markusb/esp-dmx/dmx512.png

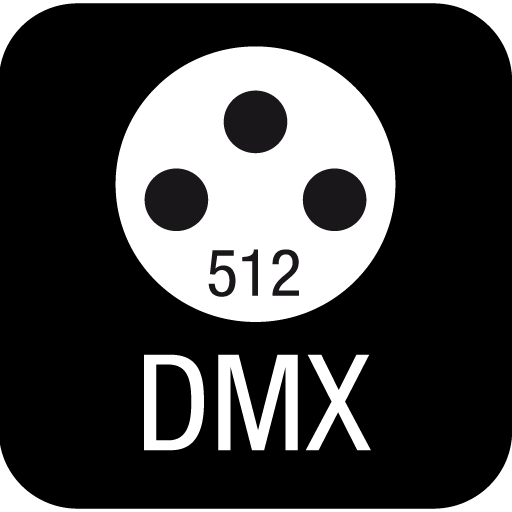
dmx512.png
