markusb/esp-dmx/Schematics.png

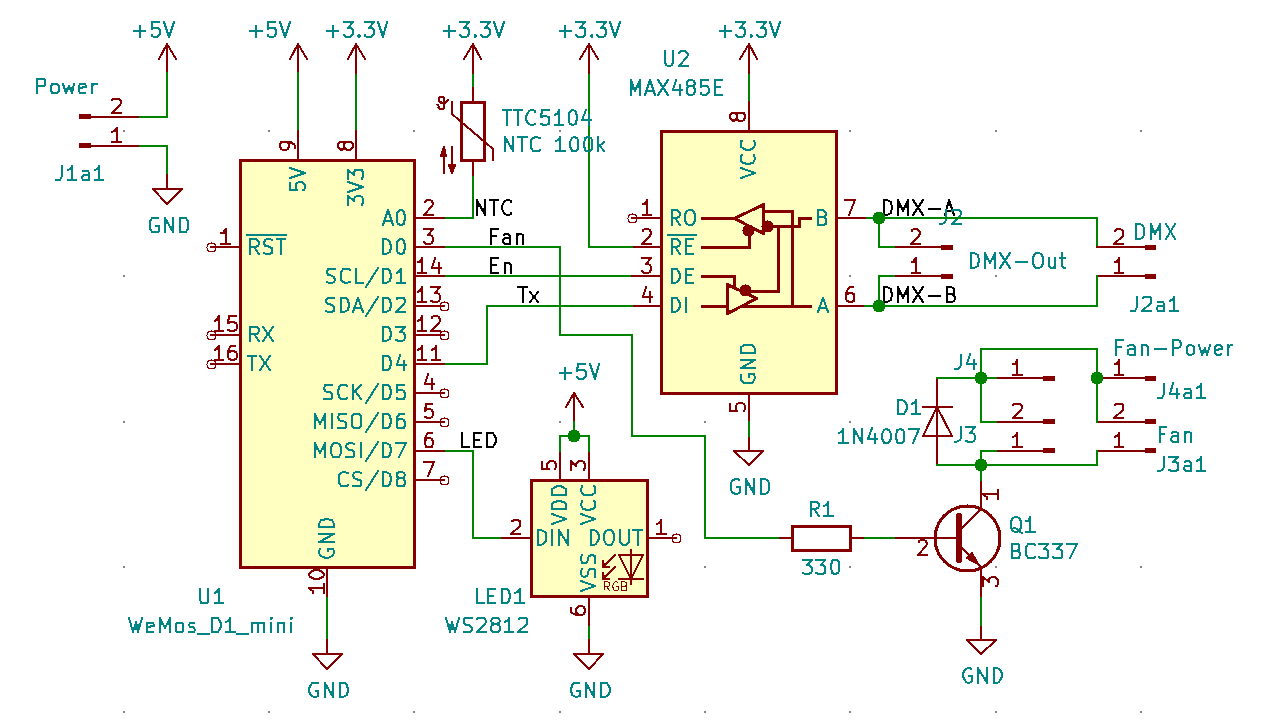
Schematics.png
