markusb/esp-dmx/Wiring-Diagram.png

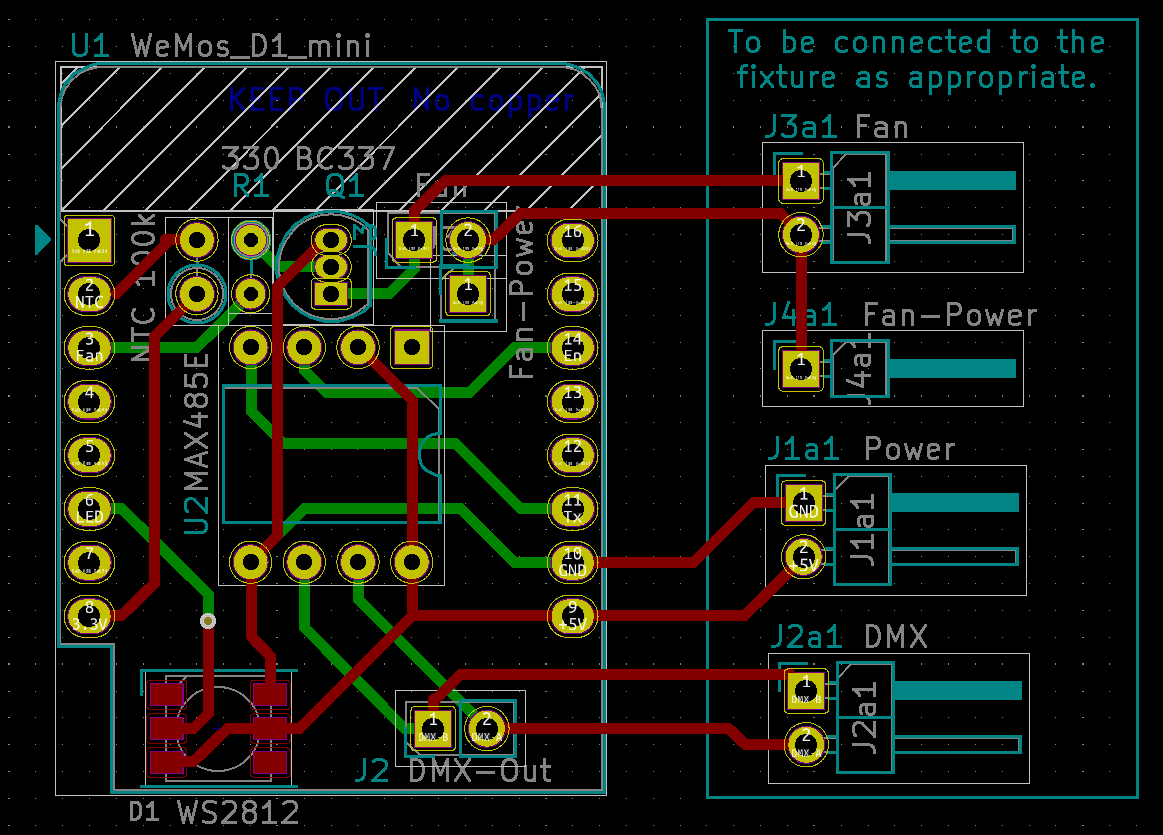
Wiring-Diagram.png
