markusb/esp-dmx/dmx512.h

/*
 * binary data for the ESP-DMX png logo
 */
 
#ifndef _DMX512_PNG_H_
#define _DMX512_PNG_H_

const char PROGMEM dmx512_png_ctype[] = "image/png";

unsigned int dmx512_png_len = 13726;

const char PROGMEM dmx512_png[] = {
  0x89, 0x50, 0x4e, 0x47, 0x0d, 0x0a, 0x1a, 0x0a, 0x00, 0x00, 0x00, 0x0d,
  0x49, 0x48, 0x44, 0x52, 0x00, 0x00, 0x02, 0x00, 0x00, 0x00, 0x02, 0x00,
  0x08, 0x06, 0x00, 0x00, 0x00, 0xf4, 0x78, 0xd4, 0xfa, 0x00, 0x00, 0x00,
  0x19, 0x74, 0x45, 0x58, 0x74, 0x53, 0x6f, 0x66, 0x74, 0x77, 0x61, 0x72,
  0x65, 0x00, 0x41, 0x64, 0x6f, 0x62, 0x65, 0x20, 0x49, 0x6d, 0x61, 0x67,
  0x65, 0x52, 0x65, 0x61, 0x64, 0x79, 0x71, 0xc9, 0x65, 0x3c, 0x00, 0x00,
  0x35, 0x40, 0x49, 0x44, 0x41, 0x54, 0x78, 0xda, 0xec, 0xdd, 0x4f, 0x4c,
  0x5c, 0x67, 0xba, 0xe7, 0xf1, 0x83, 0x9d, 0xc5, 0xac, 0x30, 0xd9, 0x8d,
  0x34, 0x46, 0xc1, 0xab, 0xd1, 0x84, 0x48, 0x86, 0xb9, 0x8a, 0xae, 0xed,
  0x8d, 0x41, 0x73, 0xd5, 0x60, 0x8d, 0x66, 0x0c, 0x51, 0xc7, 0x59, 0x1a,
  0x62, 0x1c, 0xe5, 0xae, 0x00, 0x27, 0xdb, 0x34, 0x45, 0xb2, 0xb9, 0x57,
  0x4a, 0x8c, 0x59, 0x45, 0x4a, 0xec, 0x06, 0xcf, 0x5d, 0xc5, 0x6e, 0x35,
  0xb0, 0x0a, 0x44, 0xdd, 0x32, 0x6c, 0x92, 0x5c, 0x45, 0x73, 0xc1, 0x92,
  0xf1, 0x48, 0xb3, 0x01, 0x0b, 0x5a, 0x6a, 0xcd, 0x5d, 0x18, 0xb3, 0xea,
  0x5e, 0x31, 0xf5, 0x2b, 0xd7, 0x71, 0x03, 0xae, 0x2a, 0xea, 0x3d, 0x75,
  0xfe, 0xbc, 0x7f, 0xbe, 0x1f, 0xa9, 0x42, 0xe2, 0x18, 0xa8, 0x3a, 0x75,
  0xea, 0x3c, 0xcf, 0xfb, 0xbc, 0xcf, 0xfb, 0x9e, 0xb6, 0x83, 0x83, 0x83,
  0x08, 0x00, 0x00, 0x84, 0xe5, 0x14, 0x87, 0x00, 0x00, 0x00, 0x12, 0x00,
  0x00, 0x00, 0x10, 0x80, 0x36, 0x0e, 0xc1, 0x6b, 0x7a, 0xca, 0x8f, 0x8e,
  0xea, 0xa3, 0xe7, 0xd8, 0xff, 0xbb, 0xcc, 0xe1, 0x01, 0x00, 0x6b, 0xad,
  0x1d, 0xfb, 0xef, 0x8d, 0xf2, 0x63, 0xaf, 0xfa, 0xd8, 0xe0, 0xf0, 0x90,
  0x00, 0xc4, 0xfa, 0xaa, 0x01, 0xfe, 0xad, 0xea, 0xd7, 0x38, 0xf0, 0x03,
  0x00, 0xfc, 0x14, 0x27, 0x02, 0x7a, 0x3c, 0xab, 0x7e, 0x5d, 0x25, 0x01,
  0xf0, 0x5b, 0x57, 0x35, 0xe0, 0x5f, 0x3e, 0x14, 0xec, 0x01, 0x00, 0x88,
  0x0e, 0x25, 0x05, 0x6b, 0xd5, 0x84, 0x60, 0x9b, 0x04, 0xc0, 0x6d, 0x43,
  0xd5, 0x80, 0x3f, 0x54, 0x4d, 0x00, 0x00, 0x00, 0x68, 0x86, 0x12, 0x80,
  0xc5, 0x6a, 0x42, 0xb0, 0x48, 0x02, 0xe0, 0x4e, 0xd0, 0xbf, 0x5a, 0xfd,
  0x4a, 0x39, 0x1f, 0x00, 0xd0, 0xaa, 0xbd, 0x6a, 0x12, 0xb0, 0xe4, 0x5b,
  0x32, 0xe0, 0x43, 0x02, 0xa0, 0x72, 0xfe, 0x38, 0x41, 0x1f, 0x00, 0x90,
  0x53, 0x32, 0x30, 0x1b, 0x79, 0xd0, 0x54, 0xe8, 0x72, 0x02, 0x30, 0x52,
  0x0d, 0xfc, 0xcc, 0xe7, 0x03, 0x00, 0xf2, 0xb6, 0x51, 0x4d, 0x04, 0xe6,
  0x49, 0x00, 0xf2, 0xa1, 0x11, 0xfe, 0x44, 0x35, 0xf0, 0x33, 0xda, 0x07,
  0x00, 0xd8, 0x50, 0x15, 0x50, 0x22, 0x70, 0xa7, 0xfa, 0xef, 0x24, 0x00,
  0x04, 0x7e, 0x00, 0x00, 0x89, 0x00, 0x09, 0x00, 0x81, 0x1f, 0x00, 0x40,
  0x22, 0x40, 0x02, 0xd0, 0x94, 0x12, 0x81, 0x1f, 0x00, 0xe0, 0x78, 0x22,
  0x50, 0x22, 0x01, 0x68, 0x5e, 0x5f, 0xf9, 0x31, 0x17, 0xb1, 0x76, 0x1f,
  0x00, 0xe0, 0xbe, 0xed, 0xf2, 0x63, 0x34, 0xb2, 0x70, 0xc7, 0x41, 0x9b,
  0x12, 0x80, 0x8e, 0x6a, 0xe0, 0x1f, 0xe2, 0x7c, 0x01, 0x00, 0x78, 0x66,
  0xb1, 0x9a, 0x08, 0x58, 0x33, 0x2d, 0x60, 0x4b, 0x02, 0x30, 0x54, 0x0d,
  0xfe, 0x94, 0xfb, 0x01, 0x00, 0xbe, 0xda, 0xab, 0x26, 0x01, 0x56, 0x6c,
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
};

#endif
