markusb/esp-dmx/favicon.h

/*
 * favicon binary data for the ESP-DMX webinterface
 */

#ifndef _FAVICON_H_
#define _FAVICON_H_

const char PROGMEM favicon_ctype[] = "application/octet-stream";

const unsigned int favicon_ico_len = 15406;

const char PROGMEM favicon_ico[] = {
  0x00, 0x00, 0x01, 0x00, 0x03, 0x00, 0x10, 0x10, 0x00, 0x00, 0x01, 0x00,
  0x20, 0x00, 0x68, 0x04, 0x00, 0x00, 0x36, 0x00, 0x00, 0x00, 0x20, 0x20,
  0x00, 0x00, 0x01, 0x00, 0x20, 0x00, 0x28, 0x11, 0x00, 0x00, 0x9e, 0x04,
  0x00, 0x00, 0x30, 0x30, 0x00, 0x00, 0x01, 0x00, 0x20, 0x00, 0x68, 0x26,
  0x00, 0x00, 0xc6, 0x15, 0x00, 0x00, 0x28, 0x00, 0x00, 0x00, 0x10, 0x00,
  0x00, 0x00, 0x20, 0x00, 0x00, 0x00, 0x01, 0x00, 0x20, 0x00, 0x00, 0x00,
  0x00, 0x00, 0x00, 0x00, 0x00, 0x00, 0x00, 0x00, 0x00, 0x00, 0x00, 0x00,
  0x00, 0x00, 0x00, 0x00, 0x00, 0x00, 0x00, 0x00, 0x00, 0x00, 0x00, 0x00,
  0x00, 0x1e, 0x00, 0x00, 0x00, 0xb2, 0x00, 0x00, 0x00, 0xe3, 0x00, 0x00,
  0x00, 0xe5, 0x00, 0x00, 0x00, 0xe5, 0x00, 0x00, 0x00, 0xe5, 0x00, 0x00,
  0x00, 0xe5, 0x00, 0x00, 0x00, 0xe5, 0x00, 0x00, 0x00, 0xe5, 0x00, 0x00,
  0x00, 0xe5, 0x00, 0x00, 0x00, 0xe5, 0x00, 0x00, 0x00, 0xe5, 0x00, 0x00,
  0x00, 0xe5, 0x00, 0x00, 0x00, 0xe3, 0x00, 0x00, 0x00, 0xae, 0x00, 0x00,
  0x00, 0x1b, 0x00, 0x00, 0x00, 0xc7, 0x00, 0x00, 0x00, 0xff, 0x00, 0x00,
  0x00, 0xff, 0x00, 0x00, 0x00, 0xff, 0x09, 0x09, 0x09, 0xff, 0x0b, 0x0b,
  0x0b, 0xff, 0x03, 0x03, 0x03, 0xff, 0x06, 0x06, 0x06, 0xff, 0x06, 0x06,
  0x06, 0xff, 0x0d, 0x0d, 0x0d, 0xff, 0x00, 0x00, 0x00, 0xff, 0x07, 0x07,
  0x07, 0xff, 0x00, 0x00, 0x00, 0xff, 0x00, 0x00, 0x00, 0xff, 0x00, 0x00,
  0x00, 0xff, 0x00, 0x00, 0x00, 0xbf, 0x00, 0x00, 0x00, 0xff, 0x00, 0x00,
  0x00, 0xff, 0x00, 0x00, 0x00, 0xff, 0x00, 0x00, 0x00, 0xff, 0x69, 0x69,
  0x69, 0xff, 0x5e, 0x5e, 0x5e, 0xff, 0x5f, 0x5f, 0x5f, 0xff, 0x77, 0x77,
  0x77, 0xff, 0x6e, 0x6e, 0x6e, 0xff, 0x76, 0x76, 0x76, 0xff, 0x5f, 0x5f,
  0x5f, 0xff, 0x45, 0x45, 0x45, 0xff, 0x00, 0x00, 0x00, 0xff, 0x00, 0x00,
  0x00, 0xff, 0x00, 0x00, 0x00, 0xff, 0x00, 0x00, 0x00, 0xfd, 0x00, 0x00,
  0x00, 0xff, 0x00, 0x00, 0x00, 0xff, 0x00, 0x00, 0x00, 0xff, 0x00, 0x00,
  0x00, 0xff, 0x61, 0x61, 0x61, 0xff, 0x08, 0x08, 0x08, 0xff, 0x8b, 0x8b,
  0x8b, 0xff, 0x8d, 0x8d, 0x8d, 0xff, 0x6d, 0x6d, 0x6d, 0xff, 0x4d, 0x4d,
  0x4d, 0xff, 0xa7, 0xa7, 0xa7, 0xff, 0x01, 0x01, 0x01, 0xff, 0x00, 0x00,
  0x00, 0xff, 0x00, 0x00, 0x00, 0xff, 0x00, 0x00, 0x00, 0xff, 0x00, 0x00,
  0x00, 0xff, 0x00, 0x00, 0x00, 0xff, 0x00, 0x00, 0x00, 0xff, 0x00, 0x00,
  0x00, 0xff, 0x00, 0x00, 0x00, 0xff, 0x62, 0x62, 0x62, 0xff, 0x64, 0x64,
  0x64, 0xff, 0x53, 0x53, 0x53, 0xff, 0x7c, 0x7c, 0x7c, 0xff, 0x5f, 0x5f,
  0x5f, 0xff, 0x6c, 0x6c, 0x6c, 0xff, 0x56, 0x56, 0x56, 0xff, 0x41, 0x41,
  0x41, 0xff, 0x00, 0x00, 0x00, 0xff, 0x00, 0x00, 0x00, 0xff, 0x00, 0x00,
  0x00, 0xff, 0x00, 0x00, 0x00, 0xff, 0x00, 0x00, 0x00, 0xff, 0x00, 0x00,
  0x00, 0xff, 0x00, 0x00, 0x00, 0xff, 0x00, 0x00, 0x00, 0xff, 0x00, 0x00,
  0x00, 0xff, 0x00, 0x00, 0x00, 0xff, 0x00, 0x00, 0x00, 0xff, 0x08, 0x08,
  0x08, 0xff, 0x07, 0x07, 0x07, 0xff, 0x00, 0x00, 0x00, 0xff, 0x00, 0x00,
  0x00, 0xff, 0x00, 0x00, 0x00, 0xff, 0x00, 0x00, 0x00, 0xff, 0x00, 0x00,
  0x00, 0xff, 0x00, 0x00, 0x00, 0xff, 0x00, 0x00, 0x00, 0xff, 0x00, 0x00,
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
};

#endif // _FAVICON_H_
