markusb/esp-dmx/(commit log)

2020-04-03 Fixed Serial1 port assignment in README and schematics
2020-04-04 Changed many loop seriel.prints messages into single printf
2020-04-04 Add jitter analysis (compile time option)
    [esp-dmx.ino]
2020-04-04 Move colors to include file, reduce brightness, set LEDs during update
2020-04-04 Documented schematics for future NTC/temperature controller
2020-04-05 Fixed index page, added packet length display
    [esp-dmx.h, esp-dmx.ino, webui.cpp]
2020-04-06 Added more wiring information
2020-04-08 Added Reset to defaults to config page
    [webui.cpp]
2020-04-08 Updated documentation and added fan control
2020-04-09 Implemented temperature display with NTC
2020-04-11 Fixed code formatting and comments
    [esp-dmx.ino, webui.cpp]
2020-04-13 Added partial reset options (wifi/config/all)
    [webui.cpp]
2020-04-13 reworked main loop, reception and transmission
    [esp-dmx.ino, webui.cpp]
2020-04-17 fixed powerOnShow, needs to enable driver, but remains commented
    [webui.cpp]
2020-06-12 Revamped status LED, added blinking, added poweronshow
2020-06-12 Fixed temperature reading
